dlugano32/med1-termometro/docs/datasheets/PLano sensor temperatura distancia.png

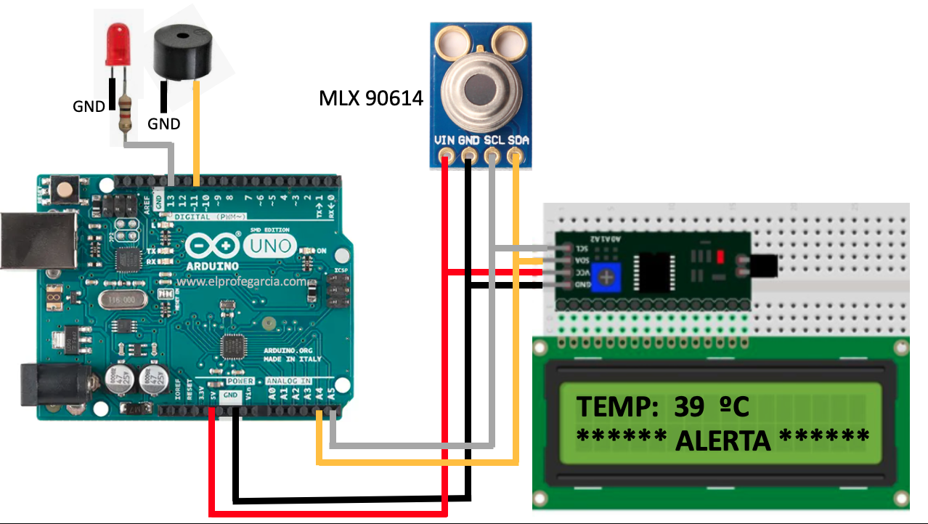
docs/datasheets/PLano sensor temperatura distancia.png
