dlugano32/med1-termometro/README.md

# Instrumento de medición : Termómetro IR | Medidas Electrónicas I - UTN FRBA 2023

Se desarrolló un dispositivo de medición de Temperatura Infrarrojo como parte de la asignatura Medidas Electrónicas I, integrada en la carrera de Ingeniería Electrónica de la UTN FRBA, en colaboración con el GIBIO. Este instrumento está diseñado para mantener una incertidumbre de 0.2 °C, utilizando el sensor MLX 90601 DCA y mostrando el valor de la temperatura al usuario a través de un display LCD. La calibración del dispositivo se llevó a cabo utilizando un termómetro digital TMP BTA del fabricante Vernier.

Entre las actividades realizadas para el desarrollo del equipo se encuentran:
+ Investigación en el mercado de instrumentos y sensores relacionados.
+ Desarrollo del firmware del sistema embebido.
+ Diseño del circuito impreso (PCB).
+ Diseño 3D del gabinete.
+ Ensamblaje del instrumento.
+ Calibración del instrumento.

## Armado y diseño


Para obtener información detallada, se recomienda consultar los manuales confeccionados:
+ [PAPER IEEE - ADN 101 IR](https://github.com/dlugano32/med1-termometro/blob/main/docs/manuales/Paper%20IEEE%20-%20ADN%20101%20IR.pdf)
+ [Manual Interno Reservado](https://github.com/dlugano32/med1-termometro/blob/main/docs/manuales/Manual_Interno_Reservado_-_ADN_101_IR.pdf)
