dlugano32/med1-termometro/TermometroIRV1.2/inc/Header_Fabricante.h

#ifndef HEADER_FABRICANTE_H
#define HEADER_FABRICANTE_H

#ifdef __cplusplus
  #define   __I     volatile             /*!< Defines 'read only' permissions */
#else
  #define   __I     volatile const       /*!< Defines 'read only' permissions */
#endif
#define     __O     volatile             /*!< Defines 'write only' permissions */
#define     __IO    volatile             /*!< Defines 'read / write' permissions */

#include <stdint.h>


#define PUERTO0 	0
#define PUERTO1 	1

#define ENTRADA 	0
#define SALIDA 		1

/* ----------------------------------------------------------------------------
   -- GPIO Peripheral Access Layer
   ---------------------------------------------------------------------------- */

/*!
 * @addtogroup GPIO_Peripheral_Access_Layer GPIO Peripheral Access Layer
 * @{
 */

/** GPIO - Register Layout Typedef */
typedef struct {
  __IO uint8_t B[2][32];                           /**< Byte pin registers for all port 0 and 1 GPIO pins, array offset: 0x0, array step: index*0x20, index2*0x1 */
       uint8_t RESERVED_0[4032];
  __IO uint32_t W[2][32];                          /**< Word pin registers for all port 0 and 1 GPIO pins, array offset: 0x1000, array step: index*0x80, index2*0x4 */
       uint8_t RESERVED_1[3840];
  __IO uint32_t DIR[2];                            /**< Direction registers, array offset: 0x2000, array step: 0x4 */
       uint8_t RESERVED_2[120];
  __IO uint32_t MASK[2];                           /**< Mask register, array offset: 0x2080, array step: 0x4 */
       uint8_t RESERVED_3[120];
  __IO uint32_t PIN[2];                            /**< Port pin register, array offset: 0x2100, array step: 0x4 */
       uint8_t RESERVED_4[120];
  __IO uint32_t MPIN[2];                           /**< Masked port register, array offset: 0x2180, array step: 0x4 */
       uint8_t RESERVED_5[120];
  __IO uint32_t SET[2];                            /**< Write: Set register for port Read: output bits for port, array offset: 0x2200, array step: 0x4 */
       uint8_t RESERVED_6[120];
  __O  uint32_t CLR[2];                            /**< Clear port, array offset: 0x2280, array step: 0x4 */
       uint8_t RESERVED_7[120];
  __O  uint32_t NOT[2];                            /**< Toggle port, array offset: 0x2300, array step: 0x4 */
       uint8_t RESERVED_8[120];
  __O  uint32_t DIRSET[2];                         /**< Set pin direction bits for port, array offset: 0x2380, array step: 0x4 */
       uint8_t RESERVED_9[120];
  __O  uint32_t DIRCLR[2];                         /**< Clear pin direction bits for port, array offset: 0x2400, array step: 0x4 */
       uint8_t RESERVED_10[120];
  __O  uint32_t DIRNOT[2];                         /**< Toggle pin direction bits for port, array offset: 0x2480, array step: 0x4 */
} GPIO_Type;

/* GPIO - Peripheral instance base addresses */
/** Peripheral GPIO base address */
#define GPIO_BASE                                (0xA0000000u)
/** Peripheral GPIO base pointer */
#define GPIO                                     ((GPIO_Type *)GPIO_BASE)
/** Array initializer of GPIO peripheral base addresses */
#define GPIO_BASE_ADDRS                          { GPIO_BASE }
/** Array initializer of GPIO peripheral base pointers */
#define GPIO_BASE_PTRS                           { GPIO }

/*!
 * @}
 */ /* end of group GPIO_Peripheral_Access_Layer */

/* ----------------------------------------------------------------------------
   -- IOCON Peripheral Access Layer
   ---------------------------------------------------------------------------- */

/*!
 * @addtogroup IOCON_Peripheral_Access_Layer IOCON Peripheral Access Layer
 * @{
 */

/** IOCON - Register Layout Typedef */
typedef struct {
  __IO uint32_t PIO[56];                           /**< Digital I/O control for pins PIO0_17..Digital I/O control for pins PIO1_10, array offset: 0x0, array step: 0x4 */
} IOCON_Type;


#define IOCON_PIO_MODE_MASK                      (0x18U)
#define IOCON_PIO_MODE_SHIFT                     (3U)

#define IOCON_PIO_OD_SHIFT                       (10U)

/* IOCON - Peripheral instance base addresses */
/** Peripheral IOCON base address */
#define IOCON_BASE                               (0x40044000u)
/** Peripheral IOCON base pointer */
#define IOCON                                    ((IOCON_Type *)IOCON_BASE)
/** Array initializer of IOCON peripheral base addresses */
#define IOCON_BASE_ADDRS                         { IOCON_BASE }
/** Array initializer of IOCON peripheral base pointers */
#define IOCON_BASE_PTRS                          { IOCON }

#define    IOCON_INDEX_PIO0_17       ( 0)
#define    IOCON_INDEX_PIO0_13       ( 1)
#define    IOCON_INDEX_PIO0_12       ( 2)
#define    IOCON_INDEX_PIO0_5        ( 3)
#define    IOCON_INDEX_PIO0_4        ( 4)
#define    IOCON_INDEX_PIO0_3        ( 5)
#define    IOCON_INDEX_PIO0_2        ( 6)
#define    IOCON_INDEX_PIO0_11       ( 7)
#define    IOCON_INDEX_PIO0_10       ( 8)
#define    IOCON_INDEX_PIO0_16       ( 9)
#define    IOCON_INDEX_PIO0_15       (10)
#define    IOCON_INDEX_PIO0_1        (11)
#define    IOCON_INDEX_PIO0_9        (13)
#define    IOCON_INDEX_PIO0_8        (14)
#define    IOCON_INDEX_PIO0_7        (15)
#define    IOCON_INDEX_PIO0_6        (16)
#define    IOCON_INDEX_PIO0_0        (17)
#define    IOCON_INDEX_PIO0_14       (18)
#define    IOCON_INDEX_PIO0_28       (20)
#define    IOCON_INDEX_PIO0_27       (21)
#define    IOCON_INDEX_PIO0_26       (22)
#define    IOCON_INDEX_PIO0_25       (23)
#define    IOCON_INDEX_PIO0_24       (24)
#define    IOCON_INDEX_PIO0_23       (25)
#define    IOCON_INDEX_PIO0_22       (26)
#define    IOCON_INDEX_PIO0_21       (27)
#define    IOCON_INDEX_PIO0_20       (28)
#define    IOCON_INDEX_PIO0_19       (29)
#define    IOCON_INDEX_PIO0_18       (30)
#define    IOCON_INDEX_PIO1_8        (31)
#define    IOCON_INDEX_PIO1_9        (32)
#define    IOCON_INDEX_PIO1_12       (33)
#define    IOCON_INDEX_PIO1_13       (34)
#define    IOCON_INDEX_PIO0_31       (35)
#define    IOCON_INDEX_PIO1_0        (36)
#define    IOCON_INDEX_PIO1_1        (37)
#define    IOCON_INDEX_PIO1_2        (38)
#define    IOCON_INDEX_PIO1_14       (39)
#define    IOCON_INDEX_PIO1_15       (40)
#define    IOCON_INDEX_PIO1_3        (41)
#define    IOCON_INDEX_PIO1_4        (42)
#define    IOCON_INDEX_PIO1_5        (43)
#define    IOCON_INDEX_PIO1_16       (44)
#define    IOCON_INDEX_PIO1_17       (45)
#define    IOCON_INDEX_PIO1_6        (46)
#define    IOCON_INDEX_PIO1_18       (47)
#define    IOCON_INDEX_PIO1_19       (48)
#define    IOCON_INDEX_PIO1_7        (49)
#define    IOCON_INDEX_PIO0_29       (50)
#define    IOCON_INDEX_PIO0_30       (51)
#define    IOCON_INDEX_PIO1_20       (52)
#define    IOCON_INDEX_PIO1_21       (53)
#define    IOCON_INDEX_PIO1_11       (54)
#define    IOCON_INDEX_PIO1_10       (55)


/*!
 * @}
 */ /* end of group IOCON_Peripheral_Access_Layer */

/* ----------------------------------------------------------------------------
   -- SYSCON Peripheral Access Layer
   ---------------------------------------------------------------------------- */

/*!
 * @addtogroup SYSCON_Peripheral_Access_Layer SYSCON Peripheral Access Layer
 * @{
 */

/** SYSCON - Register Layout Typedef */
typedef struct {
  __IO uint32_t SYSMEMREMAP;                       /**< System Remap register, offset: 0x0 */
       uint8_t RESERVED_0[4];
  __IO uint32_t SYSPLLCTRL;                        /**< PLL control, offset: 0x8 */
  __I  uint32_t SYSPLLSTAT;                        /**< PLL status, offset: 0xC */
       uint8_t RESERVED_1[16];
  __IO uint32_t SYSOSCCTRL;                        /**< system oscillator control, offset: 0x20 */
  __IO uint32_t WDTOSCCTRL;                        /**< Watchdog oscillator control, offset: 0x24 */
  __IO uint32_t FROOSCCTRL;                        /**< FRO oscillator control, offset: 0x28 */
       uint8_t RESERVED_2[4];
  __IO uint32_t FRODIRECTCLKUEN;                   /**< FRO direct clock source update enable register, offset: 0x30 */
       uint8_t RESERVED_3[4];
  __IO uint32_t SYSRSTSTAT;                        /**< System reset status register, offset: 0x38 */
       uint8_t RESERVED_4[4];
  __IO uint32_t SYSPLLCLKSEL;                      /**< System PLL clock source select register, offset: 0x40 */
  __IO uint32_t SYSPLLCLKUEN;                      /**< System PLL clock source update enable register, offset: 0x44 */
  __IO uint32_t MAINCLKPLLSEL;                     /**< Main clock source select register, offset: 0x48 */
  __IO uint32_t MAINCLKPLLUEN;                     /**< Main clock source update enable register, offset: 0x4C */
  __IO uint32_t MAINCLKSEL;                        /**< Main clock source select register, offset: 0x50 */
  __IO uint32_t MAINCLKUEN;                        /**< Main clock source update enable register, offset: 0x54 */
  __IO uint32_t SYSAHBCLKDIV;                      /**< System clock divider register, offset: 0x58 */
       uint8_t RESERVED_5[4];
  __IO uint32_t CAPTCLKSEL;                        /**< CAPT clock source select register, offset: 0x60 */
  __IO uint32_t ADCCLKSEL;                         /**< ADC clock source select register, offset: 0x64 */
  __IO uint32_t ADCCLKDIV;                         /**< ADC clock divider register, offset: 0x68 */
  __IO uint32_t SCTCLKSEL;                         /**< SCT clock source select register, offset: 0x6C */
  __IO uint32_t SCTCLKDIV;                         /**< SCT clock divider register, offset: 0x70 */
  __IO uint32_t EXTCLKSEL;                         /**< external clock source select register, offset: 0x74 */
       uint8_t RESERVED_6[8];
  __IO uint32_t SYSAHBCLKCTRL0;                    /**< System clock group 0 control register, offset: 0x80 */
  __IO uint32_t SYSAHBCLKCTRL1;                    /**< System clock group 1 control register, offset: 0x84 */
  __IO uint32_t PRESETCTRL0;                       /**< Peripheral reset group 0 control register, offset: 0x88 */
  __IO uint32_t PRESETCTRL1;                       /**< Peripheral reset group 1 control register, offset: 0x8C */
  __IO uint32_t FCLKSEL[11];                       /**< peripheral clock source select register. FCLK0SEL~FCLK4SEL are for UART0~UART4 clock source select register. FCLK5SEL~FCLK8SEL are for I2C0~I2C3 clock source select register. FCLK9SEL~FCLK10SEL are for SPI0~SPI1 clock source select register., array offset: 0x90, array step: 0x4 */
       uint8_t RESERVED_7[20];
  struct {                                         /* offset: 0xD0, array step: 0x10 */
    __IO uint32_t FRGDIV;                            /**< fractional generator N divider value register, array offset: 0xD0, array step: 0x10 */
    __IO uint32_t FRGMULT;                           /**< fractional generator N multiplier value register, array offset: 0xD4, array step: 0x10 */
    __IO uint32_t FRGCLKSEL;                         /**< FRG N clock source select register, array offset: 0xD8, array step: 0x10 */
         uint8_t RESERVED_0[4];
  } FRG[2];
  __IO uint32_t CLKOUTSEL;                         /**< CLKOUT clock source select register, offset: 0xF0 */
  __IO uint32_t CLKOUTDIV;                         /**< CLKOUT clock divider registers, offset: 0xF4 */
       uint8_t RESERVED_8[4];
  __IO uint32_t EXTTRACECMD;                       /**< External trace buffer command register, offset: 0xFC */
  __I  uint32_t PIOPORCAP[2];                      /**< POR captured PIO N status register(PIO0 has 32 PIOs, PIO1 has 22 PIOs), array offset: 0x100, array step: 0x4 */
       uint8_t RESERVED_9[44];
  __IO uint32_t IOCONCLKDIV6;                      /**< Peripheral clock 6 to the IOCON block for programmable glitch filter, offset: 0x134 */
  __IO uint32_t IOCONCLKDIV5;                      /**< Peripheral clock 6 to the IOCON block for programmable glitch filter, offset: 0x138 */
  __IO uint32_t IOCONCLKDIV4;                      /**< Peripheral clock 4 to the IOCON block for programmable glitch filter, offset: 0x13C */
  __IO uint32_t IOCONCLKDIV3;                      /**< Peripheral clock 3 to the IOCON block for programmable glitch filter, offset: 0x140 */
  __IO uint32_t IOCONCLKDIV2;                      /**< Peripheral clock 2 to the IOCON block for programmable glitch filter, offset: 0x144 */
  __IO uint32_t IOCONCLKDIV1;                      /**< Peripheral clock 1 to the IOCON block for programmable glitch filter, offset: 0x148 */
  __IO uint32_t IOCONCLKDIV0;                      /**< Peripheral clock 0 to the IOCON block for programmable glitch filter, offset: 0x14C */
  __IO uint32_t BODCTRL;                           /**< BOD control register, offset: 0x150 */
  __IO uint32_t SYSTCKCAL;                         /**< System tick timer calibration register, offset: 0x154 */
       uint8_t RESERVED_10[24];
  __IO uint32_t IRQLATENCY;                        /**< IRQ latency register, offset: 0x170 */
  __IO uint32_t NMISRC;                            /**< NMI source selection register, offset: 0x174 */
  __IO uint32_t PINTSEL[8];                        /**< Pin interrupt select registers N, array offset: 0x178, array step: 0x4 */
       uint8_t RESERVED_11[108];
  __IO uint32_t STARTERP0;                         /**< Start logic 0 pin wake-up enable register 0, offset: 0x204 */
       uint8_t RESERVED_12[12];
  __IO uint32_t STARTERP1;                         /**< Start logic 0 pin wake-up enable register 1, offset: 0x214 */
       uint8_t RESERVED_13[24];
  __IO uint32_t PDSLEEPCFG;                        /**< Deep-sleep configuration register, offset: 0x230 */
  __IO uint32_t PDAWAKECFG;                        /**< Wake-up configuration register, offset: 0x234 */
  __IO uint32_t PDRUNCFG;                          /**< Power configuration register, offset: 0x238 */
       uint8_t RESERVED_14[444];
  __I  uint32_t DEVICE_ID;                         /**< Part ID register, offset: 0x3F8 */
} SYSCON_Type;


#define SYSCON_SYSAHBCLKCTRL0_GPIO0_SHIFT        (6U)
#define SYSCON_SYSAHBCLKCTRL0_GPIO1_SHIFT        (20U)


/* SYSCON - Peripheral instance base addresses */
/** Peripheral SYSCON base address */
#define SYSCON_BASE                              (0x40048000u)
/** Peripheral SYSCON base pointer */
#define SYSCON                                   ((SYSCON_Type *)SYSCON_BASE)
/** Array initializer of SYSCON peripheral base addresses */
#define SYSCON_BASE_ADDRS                        { SYSCON_BASE }
/** Array initializer of SYSCON peripheral base pointers */
#define SYSCON_BASE_PTRS                         { SYSCON }
/** Interrupt vectors for the SYSCON peripheral type */
#define SYSCON_IRQS                              { BOD_IRQn }

/*!
 * @}
 */ /* end of group SYSCON_Peripheral_Access_Layer */

/* ----------------------------------------------------------------------------
   -- I2C Peripheral Access Layer
   ---------------------------------------------------------------------------- */

/*!
 * @addtogroup I2C_Peripheral_Access_Layer I2C Peripheral Access Layer
 * @{
 */

/** I2C - Register Layout Typedef */
typedef struct {
  __IO uint32_t CFG;                               /**< Configuration for shared functions., offset: 0x0 */
  __IO uint32_t STAT;                              /**< Status register for Master, Slave, and Monitor functions., offset: 0x4 */
  __IO uint32_t INTENSET;                          /**< Interrupt Enable Set and read register., offset: 0x8 */
  __O  uint32_t INTENCLR;                          /**< Interrupt Enable Clear register., offset: 0xC */
  __IO uint32_t TIMEOUT;                           /**< Time-out value register., offset: 0x10 */
  __IO uint32_t CLKDIV;                            /**< Clock pre-divider for the entire I2C interface. This determines what time increments are used for the MSTTIME register, and controls some timing of the Slave function., offset: 0x14 */
  __I  uint32_t INTSTAT;                           /**< Interrupt Status register for Master, Slave, and Monitor functions., offset: 0x18 */
       uint8_t RESERVED_0[4];
  __IO uint32_t MSTCTL;                            /**< Master control register., offset: 0x20 */
  __IO uint32_t MSTTIME;                           /**< Master timing configuration., offset: 0x24 */
  __IO uint32_t MSTDAT;                            /**< Combined Master receiver and transmitter data register., offset: 0x28 */
       uint8_t RESERVED_1[20];
  __IO uint32_t SLVCTL;                            /**< Slave control register., offset: 0x40 */
  __IO uint32_t SLVDAT;                            /**< Combined Slave receiver and transmitter data register., offset: 0x44 */
  __IO uint32_t SLVADR[4];                         /**< Slave address register., array offset: 0x48, array step: 0x4 */
  __IO uint32_t SLVQUAL0;                          /**< Slave Qualification for address 0., offset: 0x58 */
       uint8_t RESERVED_2[36];
  __I  uint32_t MONRXDAT;                          /**< Monitor receiver data register., offset: 0x80 */
} I2C_Type;

/* I2C - Peripheral instance base addresses */
/** Peripheral I2C0 base address */
#define I2C0_BASE                                (0x40050000u)
/** Peripheral I2C0 base pointer */
#define I2C0                                     ((I2C_Type *)I2C0_BASE)
/** Peripheral I2C1 base address */
#define I2C1_BASE                                (0x40054000u)
/** Peripheral I2C1 base pointer */
#define I2C1                                     ((I2C_Type *)I2C1_BASE)
/** Peripheral I2C2 base address */
#define I2C2_BASE                                (0x40030000u)
/** Peripheral I2C2 base pointer */
#define I2C2                                     ((I2C_Type *)I2C2_BASE)
/** Peripheral I2C3 base address */
#define I2C3_BASE                                (0x40034000u)
/** Peripheral I2C3 base pointer */
#define I2C3                                     ((I2C_Type *)I2C3_BASE)
/** Array initializer of I2C peripheral base addresses */
#define I2C_BASE_ADDRS                           { I2C0_BASE, I2C1_BASE, I2C2_BASE, I2C3_BASE }
/** Array initializer of I2C peripheral base pointers */
#define I2C_BASE_PTRS                            { I2C0, I2C1, I2C2, I2C3 }
/** Interrupt vectors for the I2C peripheral type */
#define I2C_IRQS                                 { I2C0_IRQn, I2C1_IRQn, I2C2_IRQn, I2C3_IRQn }

/*!
 * @}
 */ /* end of group I2C_Peripheral_Access_Layer */

/* ----------------------------------------------------------------------------
   -- SWM Peripheral Access Layer
   ---------------------------------------------------------------------------- */

/*!
 * @addtogroup SWM_Peripheral_Access_Layer SWM Peripheral Access Layer
 * @{
 */

/** SWM - Register Layout Typedef */
typedef struct {
  union {                                          /* offset: 0x0 */
    struct {                                         /* offset: 0x0 */
      __IO uint32_t PINASSIGN0;                        /**< Pin assign register 0. Assign movable functions U0_TXD, U0_RXD, U0_RTS, U0_CTS., offset: 0x0 */
      __IO uint32_t PINASSIGN1;                        /**< Pin assign register 1. Assign movable functions U0_SCLK, U1_TXD, U1_RXD, U1_RTS., offset: 0x4 */
      __IO uint32_t PINASSIGN2;                        /**< Pin assign register 2. Assign movable functions U1_CTS, U1_SCLK, U2_TXD, U2_RXD., offset: 0x8 */
      __IO uint32_t PINASSIGN3;                        /**< Pin assign register 3. Assign movable function U2_RTS, U2_CTS, U2_SCLK, SPI0_SCK., offset: 0xC */
      __IO uint32_t PINASSIGN4;                        /**< Pin assign register 4. Assign movable functions SPI0_MOSI, SPI0_MISO, SPI0_SSEL0, SPI0_SSEL1., offset: 0x10 */
      __IO uint32_t PINASSIGN5;                        /**< Pin assign register 5. Assign movable functions SPI0_SSEL2, SPI0_SSEL3, SPI1_SCK, SPI1_MOSI, offset: 0x14 */
      __IO uint32_t PINASSIGN6;                        /**< Pin assign register 6. Assign movable functions SPI1_MISO, SPI1_SSEL0, SPI1_SSEL1, SCT0_IN0., offset: 0x18 */
      __IO uint32_t PINASSIGN7;                        /**< Pin assign register 7. Assign movable functions SCT_IN1, SCT_IN2, SCT_IN3, SCT_OUT0., offset: 0x1C */
      __IO uint32_t PINASSIGN8;                        /**< Pin assign register 8. Assign movable functions SCT_OUT1, SCT_OUT2, SCT_OUT3, SCT_OUT4., offset: 0x20 */
      __IO uint32_t PINASSIGN9;                        /**< Pin assign register 9. Assign movable functions SCT_OUT5, SCT_OUT6, I2C1_SDA, I2C1_SCL., offset: 0x24 */
      __IO uint32_t PINASSIGN10;                       /**< Pin assign register 10. Assign movable functions I2C2_SDA, I2C2_SCL, I2C3_SDA, I2C3_SCL., offset: 0x28 */
      __IO uint32_t PINASSIGN11;                       /**< Pin assign register 11. Assign movable functions COMP0_OUT, CLKOUT, GPIOINT_BMATCH, UART3_TXD, offset: 0x2C */
      __IO uint32_t PINASSIGN12;                       /**< Pin assign register 12. Assign movable functions UART3_RXD, UART3_SCLK, UART4_TXD, UART4_RXD., offset: 0x30 */
      __IO uint32_t PINASSIGN13;                       /**< Pin assign register 13. Assign movable functions UART4_SCLK, T0_MAT0, T0_MAT1, T0_MAT2., offset: 0x34 */
      __IO uint32_t PINASSIGN14;                       /**< Pin assign register 14. Assign movable functions T0_MAT3, T0_CAP0, T0_CAP1, T0_CAP2., offset: 0x38 */
    } PINASSIGN;
    __IO uint32_t PINASSIGN_DATA[15];                /**< Pin assign register, array offset: 0x0, array step: 0x4 */
  };
       uint8_t RESERVED_0[388];
  __IO uint32_t PINENABLE0;                        /**< Pin enable register 0. Enables fixed-pin functions ACMP_I0, ACMP_I1, SWCLK, SWDIO, XTALIN, XTALOUT, RESET, CLKIN, VDDCMP and so on., offset: 0x1C0 */
  __IO uint32_t PINENABLE1;                        /**< Pin enable register 1. Enables fixed-pin functions CAPT_X4, CAPT_X5, CAPT_X6, CAPT_X7, CAPT_X8, CAPT_X4, CAPT_YL and CAPT_YH., offset: 0x1C4 */
} SWM_Type;

/* SWM - Peripheral instance base addresses */
/** Peripheral SWM0 base address */
#define SWM0_BASE                                (0x4000C000u)
/** Peripheral SWM0 base pointer */
#define SWM0                                     ((SWM_Type *)SWM0_BASE)
/** Array initializer of SWM peripheral base addresses */
#define SWM_BASE_ADDRS                           { SWM0_BASE }
/** Array initializer of SWM peripheral base pointers */
#define SWM_BASE_PTRS                            { SWM0 }


/*
 * Definiciones para Systick
 */

typedef struct {
  __IO uint32_t RESERVED[4];
  __IO uint32_t CSR;
  __IO uint32_t RVR;
  __IO uint32_t CVR;
  __IO uint32_t CALIB;

} SYSTICK_Types;


/* Systick - base addresses */
/** Peripheral Systick base address */
#define SYSTICK_BASE                                (0x0E000E000u)
/** Peripheral Systick base pointer */
#define SYSTICK                                     ((SYSTICK_Types *)SYSTICK_BASE)


/* ----------------------------------------------------------------------------
   -- SPI Peripheral Access Layer
   ---------------------------------------------------------------------------- */

/*!
 * @addtogroup SPI_Peripheral_Access_Layer SPI Peripheral Access Layer
 * @{
 */

/** SPI - Register Layout Typedef */
typedef struct {
  __IO uint32_t CFG;                               /**< SPI Configuration register, offset: 0x0 */
  __IO uint32_t DLY;                               /**< SPI Delay register, offset: 0x4 */
  __IO uint32_t STAT;                              /**< SPI Status. Some status flags can be cleared by writing a 1 to that bit position, offset: 0x8 */
  __IO uint32_t INTENSET;                          /**< SPI Interrupt Enable read and Set. A complete value may be read from this register. Writing a 1 to any implemented bit position causes that bit to be set., offset: 0xC */
  __O  uint32_t INTENCLR;                          /**< SPI Interrupt Enable Clear. Writing a 1 to any implemented bit position causes the corresponding bit in INTENSET to be cleared., offset: 0x10 */
  __I  uint32_t RXDAT;                             /**< SPI Receive Data, offset: 0x14 */
  __IO uint32_t TXDATCTL;                          /**< SPI Transmit Data with Control, offset: 0x18 */
  __IO uint32_t TXDAT;                             /**< SPI Transmit Data., offset: 0x1C */
  __IO uint32_t TXCTL;                             /**< SPI Transmit Control, offset: 0x20 */
  __IO uint32_t DIV;                               /**< SPI clock Divider, offset: 0x24 */
  __I  uint32_t INTSTAT;                           /**< SPI Interrupt Status, offset: 0x28 */
} SPI_Type;


/*!
 * @}
 */ /* end of group SPI_Register_Masks */


/* SPI - Peripheral instance base addresses */
/** Peripheral SPI0 base address */
#define SPI0_BASE                                (0x40058000u)
/** Peripheral SPI0 base pointer */
#define SPI0                                     ((SPI_Type *)SPI0_BASE)
/** Peripheral SPI1 base address */
#define SPI1_BASE                                (0x4005C000u)
/** Peripheral SPI1 base pointer */
#define SPI1                                     ((SPI_Type *)SPI1_BASE)
/** Array initializer of SPI peripheral base addresses */
#define SPI_BASE_ADDRS                           { SPI0_BASE, SPI1_BASE }
/** Array initializer of SPI peripheral base pointers */
#define SPI_BASE_PTRS                            { SPI0, SPI1 }
/** Interrupt vectors for the SPI peripheral type */
#define SPI_IRQS                                 { SPI0_IRQn, SPI1_IRQn }

/*!
 * @}
 */ /* end of group SPI_Peripheral_Access_Layer */

#define ISER0 *((uint32_t*) 0xE000E100)

typedef struct {
  __IO uint32_t CTRL;
  __IO uint32_t RESERVED;
  __IO uint32_t SEQA_CTRL;
  __IO uint32_t SEQB_CTRL;
  __IO uint32_t SEQA_GDAT;
  __IO uint32_t SEQB_GDAT;
  __IO uint32_t RESERVED2;
  __IO uint32_t RESERVED3;
  __IO uint32_t DAT0;
  __IO uint32_t DAT1;
  __IO uint32_t DAT2;
  __IO uint32_t DAT3;
  __IO uint32_t DAT4;
  __IO uint32_t DAT5;
  __IO uint32_t DAT6;
  __IO uint32_t DAT7;
  __IO uint32_t DAT8;
  __IO uint32_t DAT9;
  __IO uint32_t DAT10;
  __IO uint32_t DAT11;
  __IO uint32_t THR0_LOW;
  __IO uint32_t THR1_LOW;
  __IO uint32_t THR0_HIGH;
  __IO uint32_t THR1_HIGH;
  __IO uint32_t CHAN_THRSEL;
  __IO uint32_t INTEN;
  __IO uint32_t FLAGS;
  __IO uint32_t TRM;

} ADC_Types;


#define ADC_BASE		(0x04001C000u)
#define ADC      		((ADC_Types *)ADC_BASE)


#endif
