dlugano32/med1-termometro/TermometroIRV1.2/inc/DR_big_numbers_fonts.h

/*
 * DR_big_numbers_fonts.h
 *
 *  Created on: 25 ago. 2023
 *      Author: akato
 */

#ifndef DR_BIG_NUMBERS_FONTS_H_
#define DR_BIG_NUMBERS_FONTS_H_

static const uint8_t big_numbers [][20] =
{
// 4 Cuadrados de 5x8 pixeles que forman el 0
{0b00000000, 0b11111100, 0b00000010, 0b00000010, 0b00000010
,0b00000010, 0b00000010, 0b00000010, 0b11111100, 0b00000000
,0b00000000, 0b00111111, 0b01000000, 0b01000000, 0b01000000
,0b01000000, 0b01000000, 0b01000000, 0b00111111, 0b00000000},
// 4 Cuadrados de 5x8 pixeles que forman el 1
{0b00000000, 0b00000000, 0b00001000, 0b00000100, 0b00000010
,0b11111110, 0b00000000, 0b00000000, 0b00000000, 0b00000000
,0b00000000, 0b00000000, 0b01000000, 0b01000000, 0b01000000
,0b01111111, 0b01000000, 0b01000000, 0b01000000, 0b00000000},
// 4 Cuadrados de 5x8 pixeles que forman el 2
{0b00000000, 0b00011000, 0b00000100, 0b00000010, 0b00000010
,0b00000010, 0b10000010, 0b01000100, 0b00111000, 0b00000000
,0b00000000, 0b01110000, 0b01001000, 0b01000100, 0b01000010
,0b01000001, 0b01000000, 0b01000000, 0b01100000, 0b00000000},
// 4 Cuadrados de 5x8 pixeles que forman el 3
{0b00000000, 0b00000010, 0b00000010, 0b00000010, 0b00100010
,0b01010010, 0b01001010, 0b10000110, 0b00000010, 0b00000000
,0b00000000, 0b00100000, 0b01000000, 0b01000000, 0b01000000
,0b01000000, 0b01000000, 0b00100000, 0b00011111, 0b00000000},
// 4 Cuadrados de 5x8 pixeles que forman el 4
{0b00000000, 0b00000000, 0b11111110, 0b10000000, 0b10000000
,0b10000000, 0b10000000, 0b10000000, 0b11111110, 0b00000000
,0b00000000, 0b00000000, 0b00000000, 0b00000000, 0b00000000
,0b00000000, 0b00000000, 0b00000000, 0b01111111, 0b00000000},
// 4 Cuadrados de 5x8 pixeles que forman el 5
{0b00000000, 0b01111110, 0b01000010, 0b01000010, 0b01000010
,0b01000010, 0b01000010, 0b10000010, 0b00000000, 0b00000000
,0b00000000, 0b01000000, 0b01000000, 0b01000000, 0b01000000
,0b01000000, 0b01000000, 0b00100000, 0b00011111, 0b00000000},
// 4 Cuadrados de 5x8 pixeles que forman el 6
{0b00000000, 0b00000000, 0b11111000, 0b10000100, 0b10000010
,0b10000010, 0b10000010, 0b10000010, 0b00000000, 0b00000000
,0b00000000, 0b00000000, 0b00111111, 0b01000000, 0b01000000
,0b01000000, 0b01000000, 0b01000000, 0b00111111, 0b00000000},
// 4 Cuadrados de 5x8 pixeles que forman el 7
{0b00000000, 0b00000010, 0b00000010, 0b00000010, 0b00000010
,0b00000010, 0b00000010, 0b00000010, 0b11111110, 0b00000000
,0b00000000, 0b00000000, 0b00000000, 0b00000000, 0b00000000
,0b00000000, 0b00000000, 0b00000000, 0b01111111, 0b00000000},
// 4 Cuadrados de 5x8 pixeles que forman el 8
{0b00000000, 0b01111100, 0b10000010, 0b10000010, 0b10000010
,0b10000010, 0b10000010, 0b10000010, 0b01111100, 0b00000000
,0b00000000, 0b00111111, 0b01000000, 0b01000000, 0b01000000
,0b01000000, 0b01000000, 0b01000000, 0b00111111, 0b00000000},
// 4 Cuadrados de 5x8 pixeles que forman el 9
{0b00000000, 0b11111100, 0b00000010, 0b00000010, 0b00000010
,0b00000010, 0b00000010, 0b00000010, 0b11111100, 0b00000000
,0b00000000, 0b00100000, 0b01000001, 0b01000001, 0b01000001
,0b01000001, 0b01000001, 0b01000001, 0b00111111, 0b00000000},
// 4 Cuadrados de 5x8 pixeles que forman el punto "."
{0b00000000, 0b00000000, 0b00000000, 0b00000000, 0b00000000
,0b00000000, 0b00000000, 0b00000000, 0b00000000, 0b00000000
,0b00000000, 0b01100000, 0b01100000, 0b01100000, 0b00000000
,0b00000000, 0b00000000, 0b00000000, 0b00000000, 0b00000000}
};

static const uint8_t celsius_char [] =
{0b00000000, 0b00000000, 0b00000000, 0b00111100, 0b01000010
,0b01000010, 0b00111100, 0b00000000, 0b00000000, 0b00000000
,0b00000000, 0b11111000, 0b00000100, 0b00000010, 0b00000010
,0b00000010, 0b00000010, 0b00000010, 0b00000100, 0b00000000
,0b00000000, 0b00000000, 0b00000000, 0b00000000, 0b00000000
,0b00000000, 0b00000000, 0b00000000, 0b00000000, 0b00000000
,0b00000000, 0b00011111, 0b00100000, 0b01000000, 0b01000000
,0b01000000, 0b01000000, 0b01000000, 0b00100000, 0b00000000
};

#endif /* DR_BIG_NUMBERS_FONTS_H_ */
