dlugano32/med1-termometro/TermometroIRV1.2/inc/DR_ADC.h

/*
 * DR_ADC.h
 *
 *  Created on: 14 nov. 2021
 *      Author: d_lugano
 */

#ifndef DR_ADC_H_
#define DR_ADC_H_

#include "../inc/Header_Fabricante.h"
#include "../inc/Firmware.h"

#define CLK 30000000
#define SAMPLE 10000

#define CANT_MUESTRAS 5

void InitADC(void);

extern uint32_t resultadoADC;
extern uint8_t flagADC;

#endif /* DR_ADC_H_ */
