dlugano32/med1-termometro/TermometroIRV1.2/inc/DR_Systick.h

/*
 * DR_Systick.h
 *
 *  Created on: 30 May 2023
 *      Author: dlugano
 */

#ifndef DR_SYSTICK_H_
#define DR_SYSTICK_H_

#include "../inc/DR_switch.h"

void SysTick_Handler(void);

#endif /* DR_SYSTICK_H_ */
