dlugano32/med1-termometro/TermometroIRV1.2/inc/PR_ADC.h

/*
 * PR_ADC.h
 *
 *  Created on: 14 nov. 2021
 *      Author: d_lugano
 */

#ifndef PR_ADC_H_
#define PR_ADC_H_

#include "DR_ADC.h"

#define VREF 3.3
#define NBITS 4096

double LeerVDD(void);

#endif /* PR_ADC_H_ */
