dlugano32/med1-termometro/TermometroIRV1.2/inc/TermometroApp.h

#ifndef TERMOMETROAPP_H_
#define TERMOMETROAPP_H_

#include "../inc/DR_Init.h"
#include "../inc/PR_MLX90614.h"
#include "../inc/Firmware.h"
#include "../inc/DR_switch.h"
#include "../inc/PR_display.h"
#include "../inc/PR_ADC.h"
#include "../Librerias/ftoa.h"

enum STATESMDE{ESPERANDO, MIDIENDO_TEMP, DISPLAY_TEMP};

#define CANT_MEDICIONES 10

void InitTermometroMDE(void);
void TermometroMDE(void);
uint8_t MedicionTemp(void);
#endif /* TERMOMETROAPP_H_ */
